Ternura-xiang/Temperature/Doc/SCH_Schematic1_2026-10-23.pdf

温湿度计 | 电池 | 屏幕驱动 & 屏幕接口

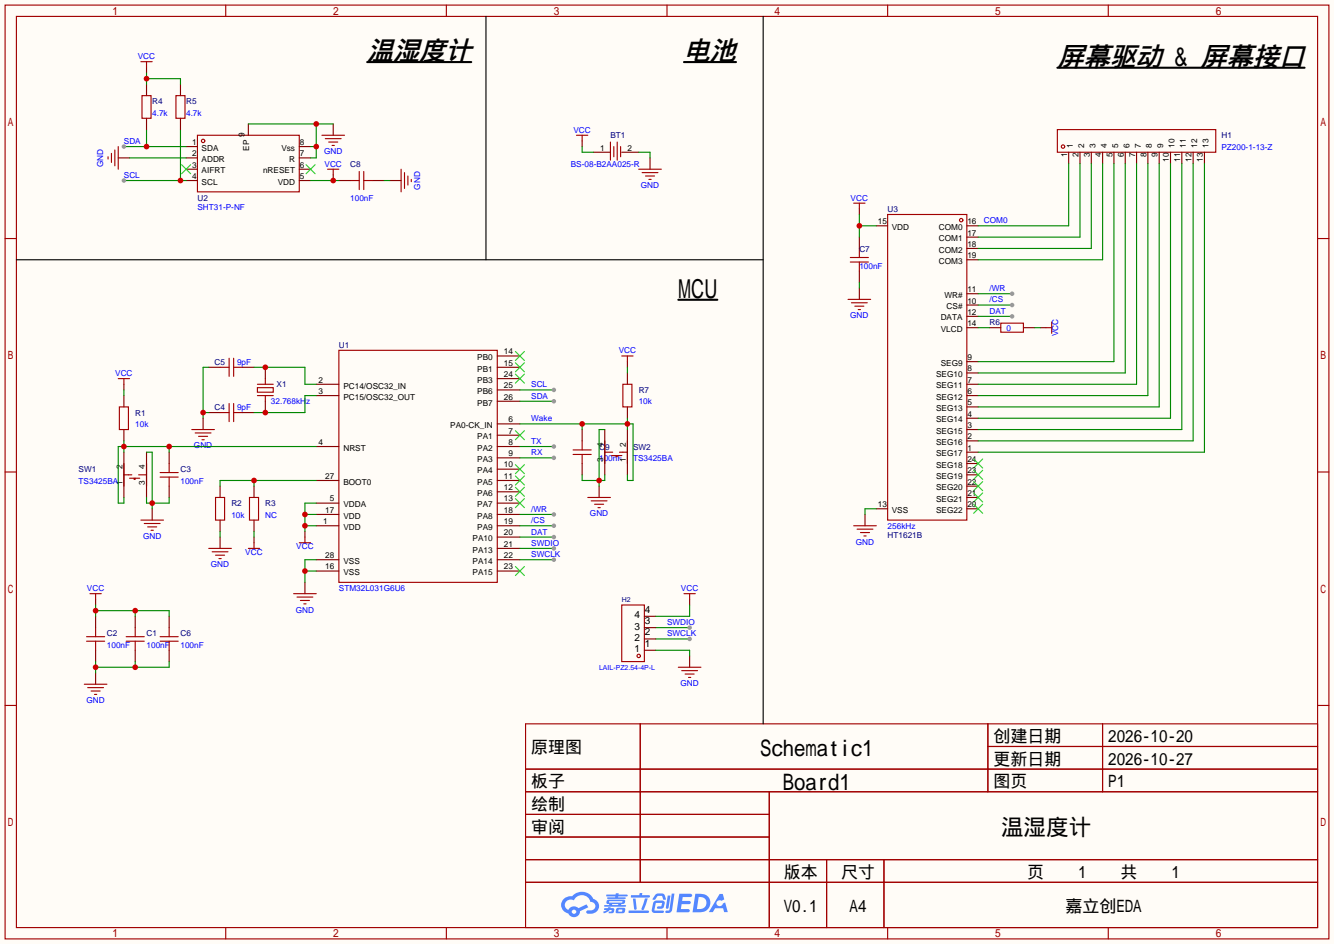
[picture p1: page 1]

原理图 | Schematic1 | 创建日期 | 2026-10-20

更新日期 | 2026-10-27

板子 | Board1 | 图页 | P1
绘制 | | 温湿度计
审阅

V0.1 | A4 | 嘉立创EDA
