Ternura-xiang/Temperature/Core/Inc/main.h

#define WR_Pin GPIO_PIN_8
#define WR_GPIO_Port GPIOA
#define CS_Pin GPIO_PIN_9
#define CS_GPIO_Port GPIOA
#define DAT_Pin GPIO_PIN_10
#define DAT_GPIO_Port GPIOA
